NonthapatC/RapidAmentePDM/Controller/PDMController.step

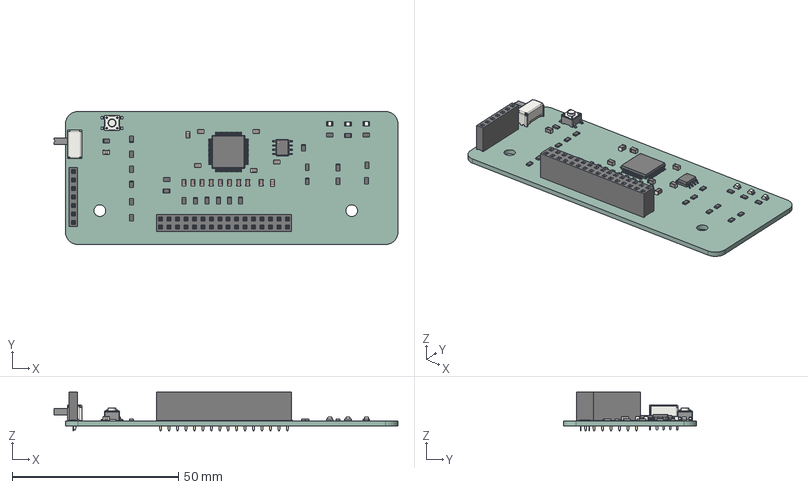
[picture p1: CAD file, 2026-08-03]
Controller/PDMController.step
103.4 x 40.0 x 11.6 mm
R_0805_2012Metric x 25
C_0805_2012Metric x 17
LED_0805_2012Metric x 3
LQFP-64_10x10mm_P0.5mm
SW_Slide_SPDT_Angled_CK_OS102011MA1Q
PinSocket_2x16_P2.54mm_Vertical
SW_SPST_PTS647Sx38
SOIC-8_3.9x4.9mm_P1.27mm
PinSocket_1x07_P2.54mm_Vertical
STM32 V2_PCB
