NonthapatC/RapidAmentePDM/KiCad_PDM/3Ds/XFCN T66145145-1500.step

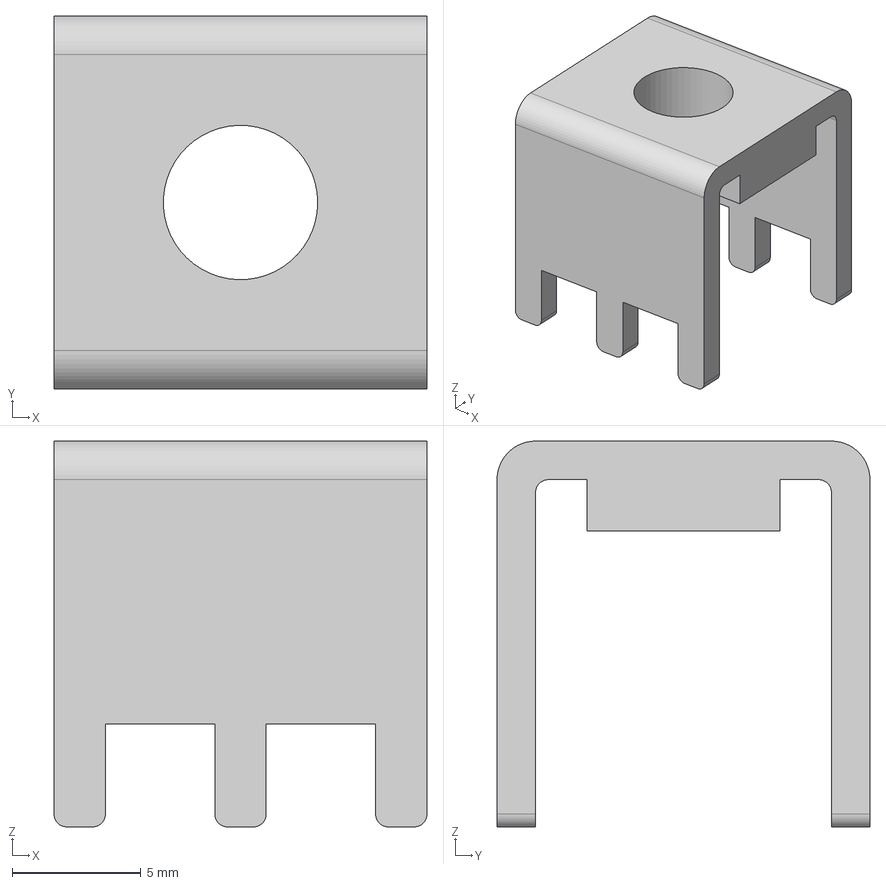
[picture p2: CAD file, 2026-04-13]
KiCad_PDM/3Ds/XFCN T66145145-1500.step
14.5 x 14.5 x 15.0 mm
