NonthapatC/RapidAmentePDM/Production/MK2_PDM.step

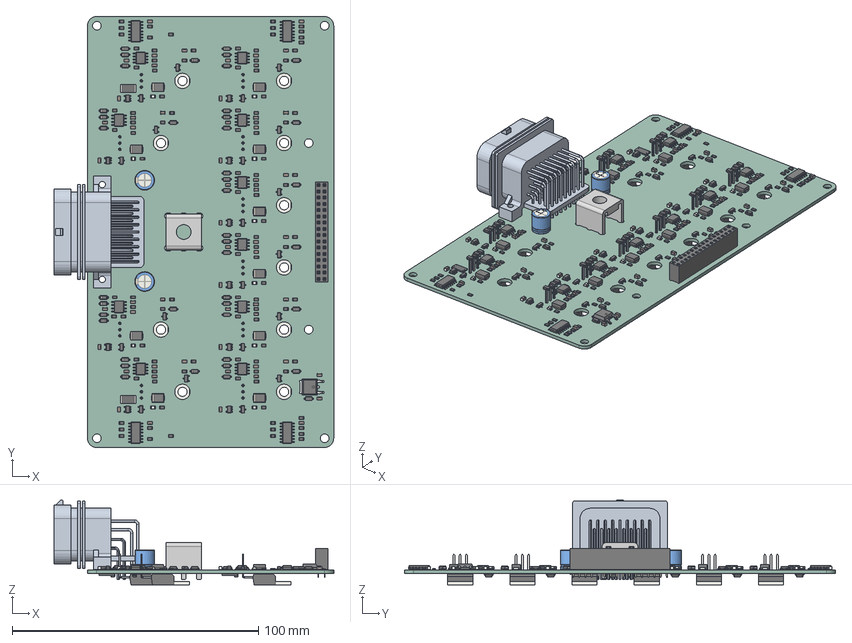
[picture p3: CAD file, 2026-07-30]
Production/MK2_PDM.step
113.5 x 175.0 x 34.3 mm
R_0805_2012Metric x 106
D_SMB x 10
C_0805_2012Metric x 56
D_SOD-123 x 51
SOT-23-5 x 10
SOT-23 x 20
SOIC-8_3.9x4.9mm_P1.27mm x 10
LED_0805_2012Metric x 10
Soldered Terminal XFCN T66145145-1500 v1
SOIC-14_3.9x8.7mm_P1.27mm x 4
R_2512_6332Metric x 10
CP_Radial_D80mm_P250mm x 2
C-6437288-1
932d09b3-9c39-11ed-93f0-dde97e994e83_part
932d09b4-9c39-11ed-93f0-dde97e994e83_part
932d09b5-9c39-11ed-93f0-dde97e994e83_part
PinSocket_2x16_P2.54mm_Vertical
TO-220-3_Horizontal_TabUp x 10
KiCad_PDM_PCB
