NonthapatC/RapidAmentePDM/Production/MK2_PDM_Design_Constraint.step

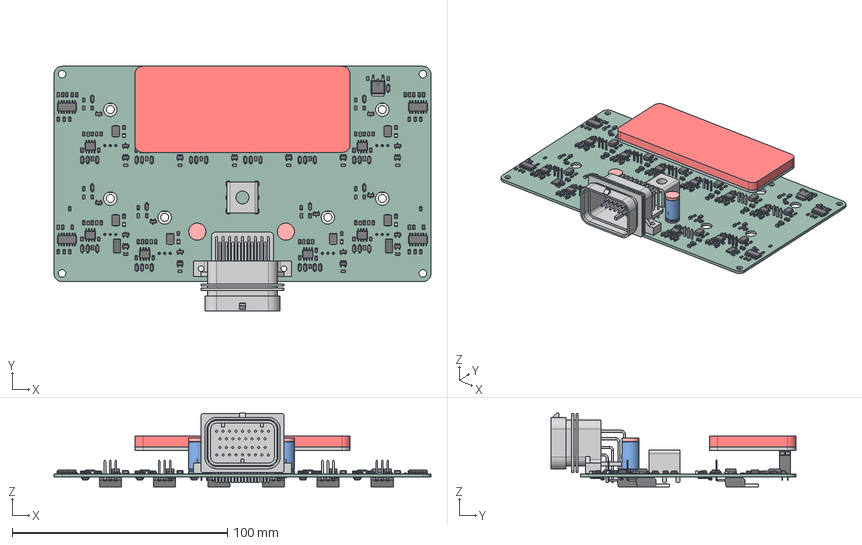
[picture p4: CAD file, 2026-07-30]
Production/MK2_PDM_Design_Constraint.step
175.0 x 113.5 x 34.3 mm
R_0805_2012Metric_1 x 106
D_SMB_1 x 10
C_0805_2012Metric_1 x 56
D_SOD-123_1 x 51
SOT-23-5_1 x 10
SOT-23_1 x 20
SOIC-8_3.9x4.9mm_P1.27mm_1 x 10
LED_0805_2012Metric_1 x 10
Soldered Terminal XFCN T66145145-1500 v1
SOIC-14_3.9x8.7mm_P1.27mm_1 x 4
R_2512_6332Metric_1 x 10
CP_Radial_D80mm_P250mm x 2
C-6437288-1
932d09b3-9c39-11ed-93f0-dde97e994e83_part
932d09b4-9c39-11ed-93f0-dde97e994e83_part
932d09b5-9c39-11ed-93f0-dde97e994e83_part
PinSocket_2x16_P2.54mm_Vertical_1
TO-220-3_Horizontal_TabUp_1 x 10
KiCad_PDM_PCB
100mill Male Pin Header_4P_Bk x 8
PDM_Board 2
PDM_Exclusion Volume
Bulk Caps Exclusion Volume x 2
