NonthapatC/RapidAmentePDM/KiCad_PDM/3Ds/6437288-1.stp

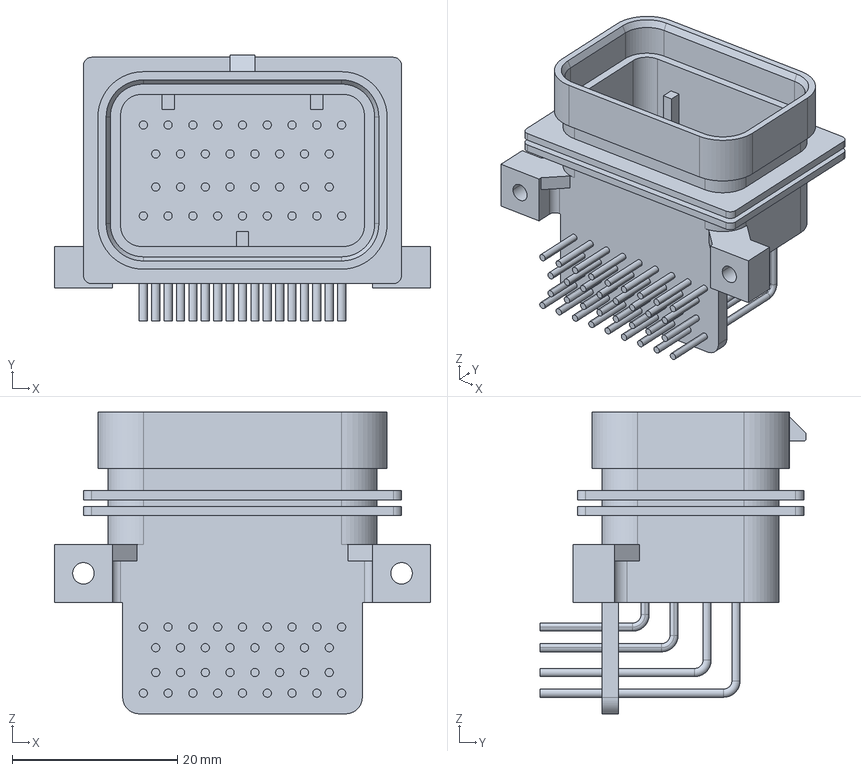
[picture p5: CAD file, 2026-04-03]
KiCad_PDM/3Ds/6437288-1.stp
45.5 x 32.1 x 36.5 mm
