NonthapatC/RapidAmentePDM/(list of files, cad)

Other CAD files:
Production/MK2_PDM_Design_Constraint.f3z
