NonthapatC/RapidAmentePDM/Controller/STM32 V2/STM32 V2.kicad_pcb

## KiCad design Controller/STM32 V2/STM32 V2.kicad_pcb (2026-08-03)

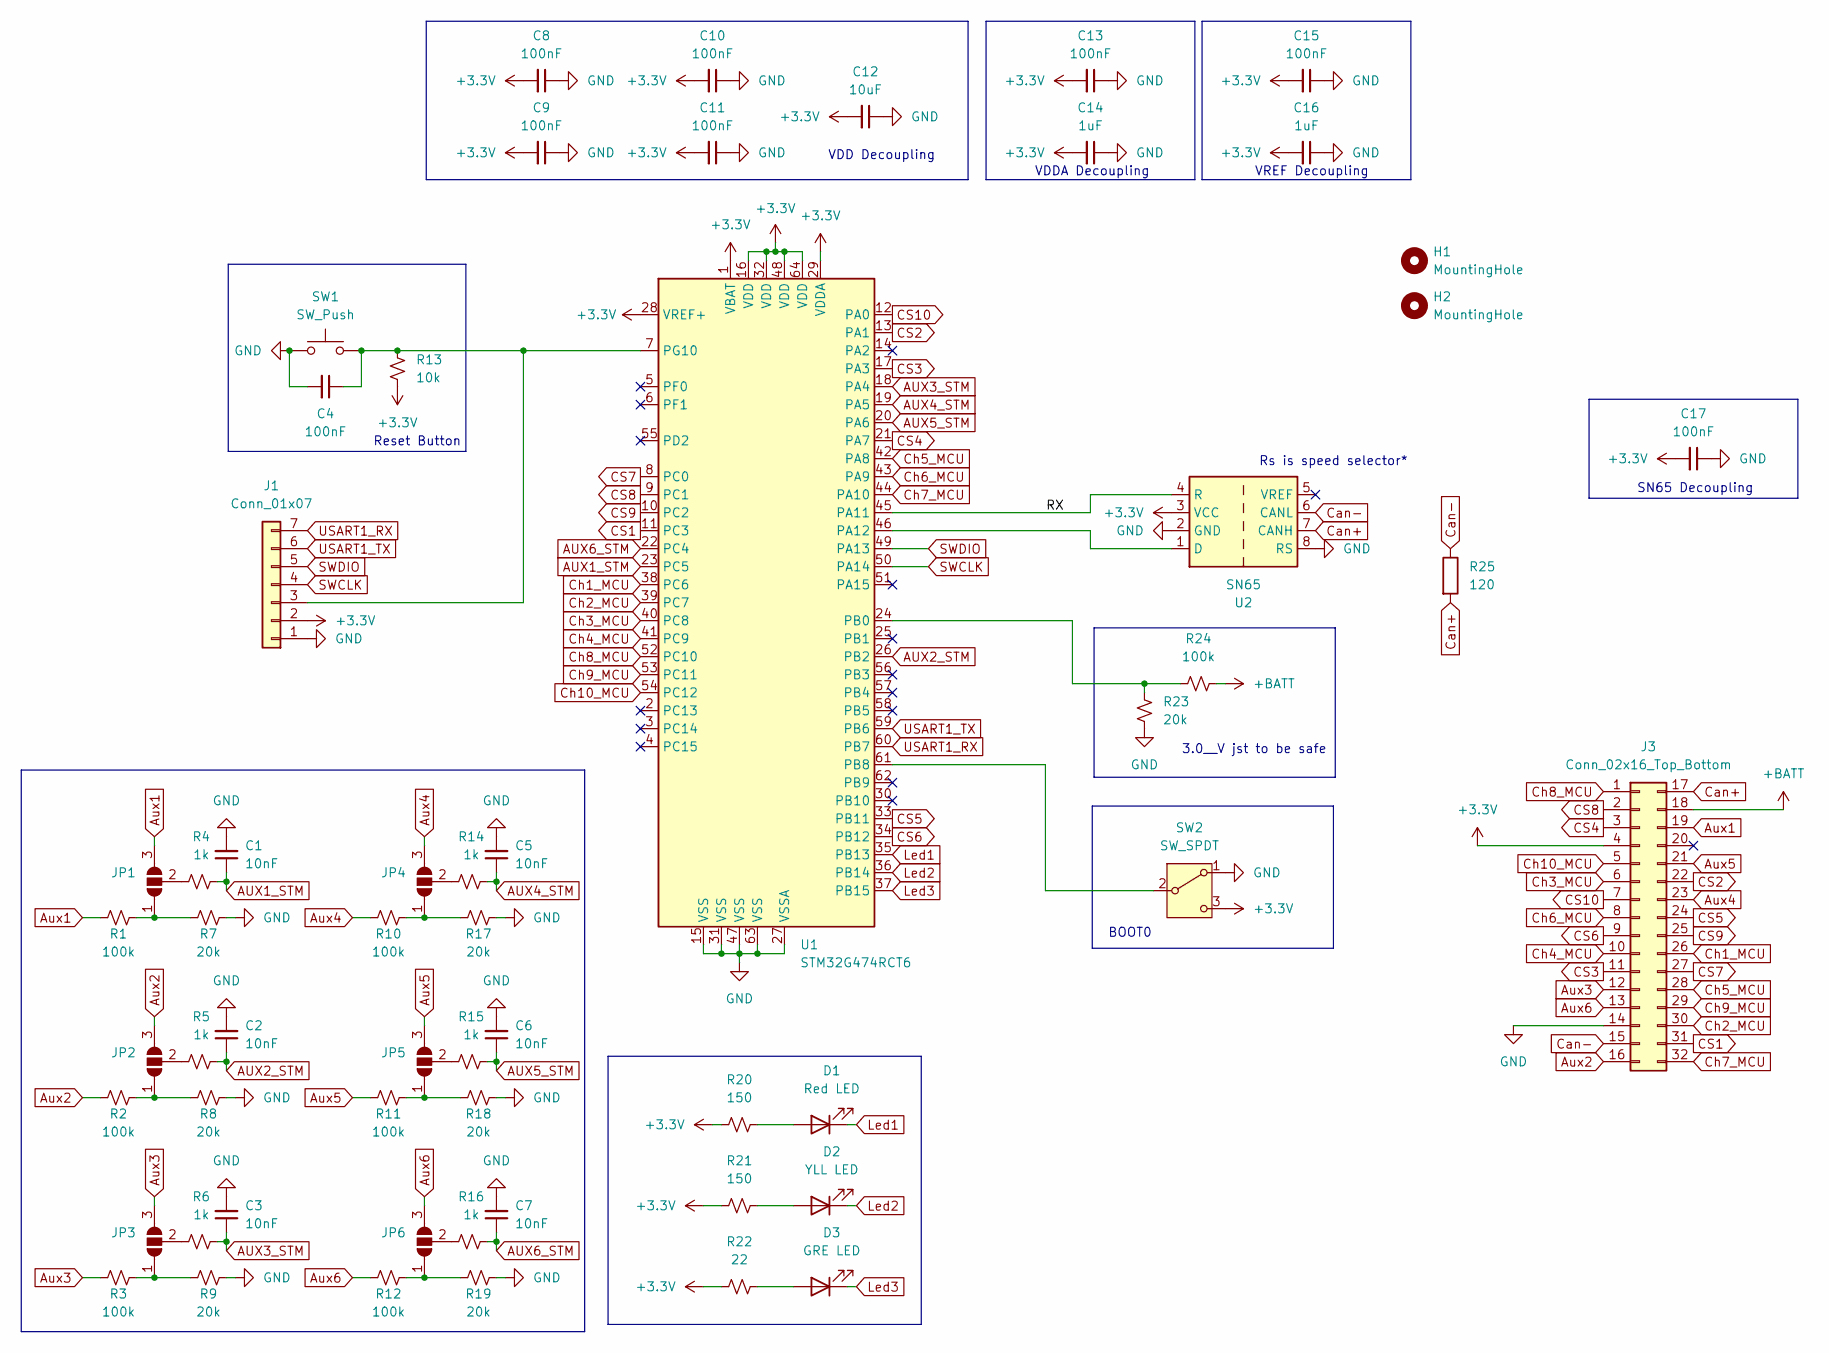
[picture p6: schematic STM32 V2.kicad_sch, STM 32 Board]

Parts:
C1, C2, C3, C5, C6, C7: 10nF; C_0805_2012Metric_Pad1.18x1.45mm_HandSolder
C4, C8, C9, C10, C11, C13, C15, C17: 100nF; C_0805_2012Metric_Pad1.18x1.45mm_HandSolder
C12: 10uF; C_0805_2012Metric_Pad1.18x1.45mm_HandSolder
C14, C16: 1uF; C_0805_2012Metric_Pad1.18x1.45mm_HandSolder
D1: Red LED; LED_0805_2012Metric_Pad1.15x1.40mm_HandSolder
D2: YLL LED; LED_0805_2012Metric_Pad1.15x1.40mm_HandSolder
D3: GRE LED; LED_0805_2012Metric_Pad1.15x1.40mm_HandSolder
H1, H2: MountingHole; MountingHole_NPTH_3.5_6.25SB
J1: Conn_01x07; PinSocket_1x07_P2.54mm_Vertical
J3: Conn_02x16_Top_Bottom; PinSocket_2x16_P2.54mm_Vertical
JP1, JP2, JP3, JP4, JP5, JP6: SolderJumper_3_Open; SolderJumper-3_P1.3mm_Open_RoundedPad1.0x1.5mm_NumberLabels
R1, R2, R3, R10, R11, R12, R24: 100k; R_0805_2012Metric_Pad1.20x1.40mm_HandSolder
R4, R5, R6, R14, R15, R16: 1k; R_0805_2012Metric_Pad1.20x1.40mm_HandSolder
R7, R8, R9, R17, R18, R19, R23: 20k; R_0805_2012Metric_Pad1.20x1.40mm_HandSolder
R13: 10k; R_0805_2012Metric_Pad1.20x1.40mm_HandSolder
R20, R21: 150; R_0805_2012Metric_Pad1.20x1.40mm_HandSolder
R22: 22; R_0805_2012Metric_Pad1.20x1.40mm_HandSolder
R25: 120; R_0805_2012Metric_Pad1.20x1.40mm_HandSolder
SW1: SW_Push; SW_SPST_PTS647_Sx38
SW2: SW_SPDT; HOOYA MK-12D13G4-B
U1: STM32G474RCT6; LQFP-64_10x10mm_P0.5mm
U2: SN65; SOIC-8_3.9x4.9mm_P1.27mm

Connections:
+3.3V: C8.2, C9.2, C10.2, C11.2, C12.2, C13.2, C14.2, C15.2, C16.2, C17.2, J1.2, J3.4, R13.2, R20.2, R21.2, R22.2, SW2.3 (C), U1.1 (VBAT), U1.16 (VDD), U1.28 (VREF+), U1.29 (VDDA), U1.32 (VDD), U1.48 (VDD), U1.64 (VDD), U2.3 (VCC)
+BATT: J3.18, R24.2
/RX: U1.45 (PA11), U2.4 (R)
AUX1_STM: C1.1, R4.2, U1.23 (PC5)
AUX2_STM: C2.1, R5.2, U1.26 (PB2)
AUX3_STM: C3.1, R6.2, U1.18 (PA4)
AUX4_STM: C5.1, R14.2, U1.19 (PA5)
AUX5_STM: C6.1, R15.2, U1.20 (PA6)
AUX6_STM: C7.1, R16.2, U1.22 (PC4)
Aux1: J3.19, JP1.3 (B), R1.1
Aux2: J3.16, JP2.3 (B), R2.1
Aux3: J3.12, JP3.3 (B), R3.1
Aux4: J3.23, JP4.3 (B), R10.1
Aux5: J3.21, JP5.3 (B), R11.1
Aux6: J3.13, JP6.3 (B), R12.1
CS1: J3.31, U1.11 (PC3)
CS2: J3.22, U1.13 (PA1)
CS3: J3.11, U1.17 (PA3)
CS4: J3.3, U1.21 (PA7)
CS5: J3.24, U1.33 (PB11)
CS6: J3.9, U1.34 (PB12)
CS7: J3.27, U1.8 (PC0)
CS8: J3.2, U1.9 (PC1)
CS9: J3.25, U1.10 (PC2)
CS10: J3.7, U1.12 (PA0)
Can+: J3.17, R25.2, U2.7 (CANH)
Can-: J3.15, R25.1, U2.6 (CANL)
Ch1_MCU: J3.26, U1.38 (PC6)
Ch2_MCU: J3.30, U1.39 (PC7)
Ch3_MCU: J3.6, U1.40 (PC8)
Ch4_MCU: J3.10, U1.41 (PC9)
Ch5_MCU: J3.28, U1.42 (PA8)
Ch6_MCU: J3.8, U1.43 (PA9)
Ch7_MCU: J3.32, U1.44 (PA10)
Ch8_MCU: J3.1, U1.52 (PC10)
Ch9_MCU: J3.29, U1.53 (PC11)
Ch10_MCU: J3.5, U1.54 (PC12)
GND: C1.2, C2.2, C3.2, C4.2, C5.2, C6.2, C7.2, C8.1, C9.1, C10.1, C11.1, C12.1, C13.1, C14.1, C15.1, C16.1, C17.1, J1.1, J3.14, R7.2, R8.2, R9.2, R17.2, R18.2, R19.2, R23.1, SW1.1, SW2.1 (A), U1.15 (VSS), U1.27 (VSSA), U1.31 (VSS), U1.47 (VSS), U1.63 (VSS), U2.2 (GND), U2.8 (RS)
Led1: D1.1 (K), U1.35 (PB13)
Led2: D2.1 (K), U1.36 (PB14)
Led3: D3.1 (K), U1.37 (PB15)
unnamed: D1.2 (A), R20.1
unnamed: D2.2 (A), R21.1
unnamed: D3.2 (A), R22.1
unnamed: C4.1, J1.3, R13.1, SW1.2, U1.7 (PG10)
unnamed: JP1.1 (A), R1.2, R7.1
unnamed: JP1.2 (C), R4.1
unnamed: JP2.1 (A), R2.2, R8.1
unnamed: JP2.2 (C), R5.1
unnamed: JP3.1 (A), R3.2, R9.1
unnamed: JP3.2 (C), R6.1
unnamed: JP4.1 (A), R10.2, R17.1
unnamed: JP4.2 (C), R14.1
unnamed: JP5.1 (A), R11.2, R18.1
unnamed: JP5.2 (C), R15.1
unnamed: JP6.1 (A), R12.2, R19.1
unnamed: JP6.2 (C), R16.1
unnamed: SW2.2 (B), U1.61 (PB8)
unnamed: U1.46 (PA12), U2.1 (D)
unnamed: R23.2, R24.1, U1.24 (PB0)
SWCLK: J1.4, U1.50 (PA14)
SWDIO: J1.5, U1.49 (PA13)
USART1_RX: J1.7, U1.60 (PB7)
USART1_TX: J1.6, U1.59 (PB6)

Notes on the sheet:
BOOT0
SN65 Decoupling
VDD Decoupling
Reset Button
VREF Decoupling
VDDA Decoupling
3.0__V jst to be safe
Rs is speed selector*

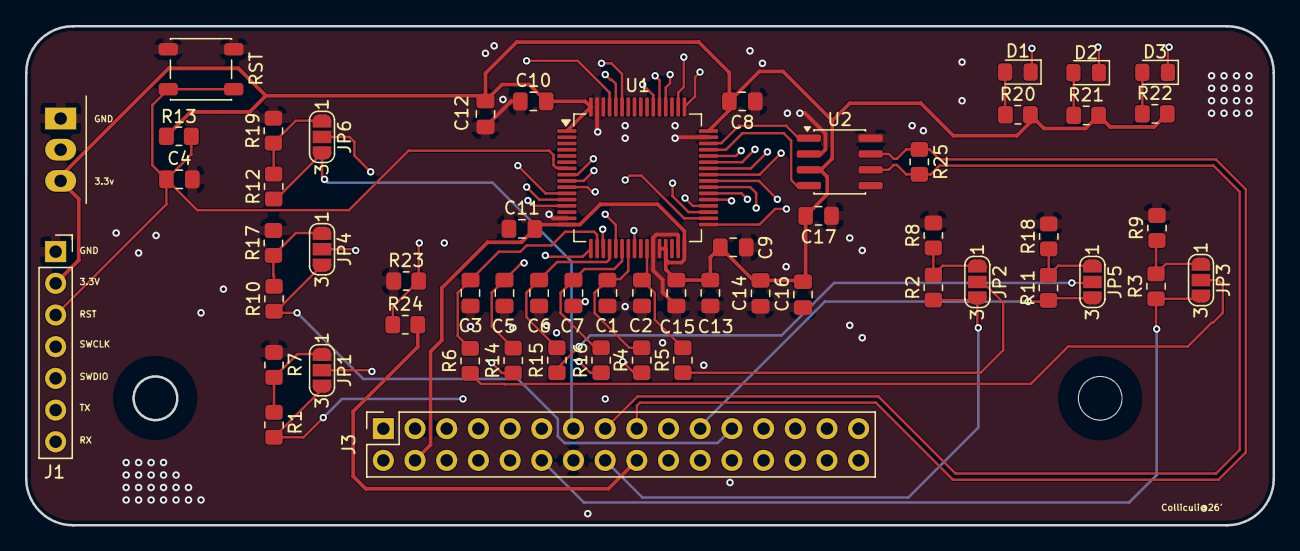
[picture p7: board STM32 V2.kicad_pcb from above]

Board: 4 copper layers, 100.0 x 40.0 mm, 59 parts (0 on the bottom side), 64 nets.
