NonthapatC/RapidAmentePDM/KiCad_PDM/KiCad_PDM.kicad_pcb

## KiCad design KiCad_PDM/KiCad_PDM.kicad_pcb (2026-08-02)

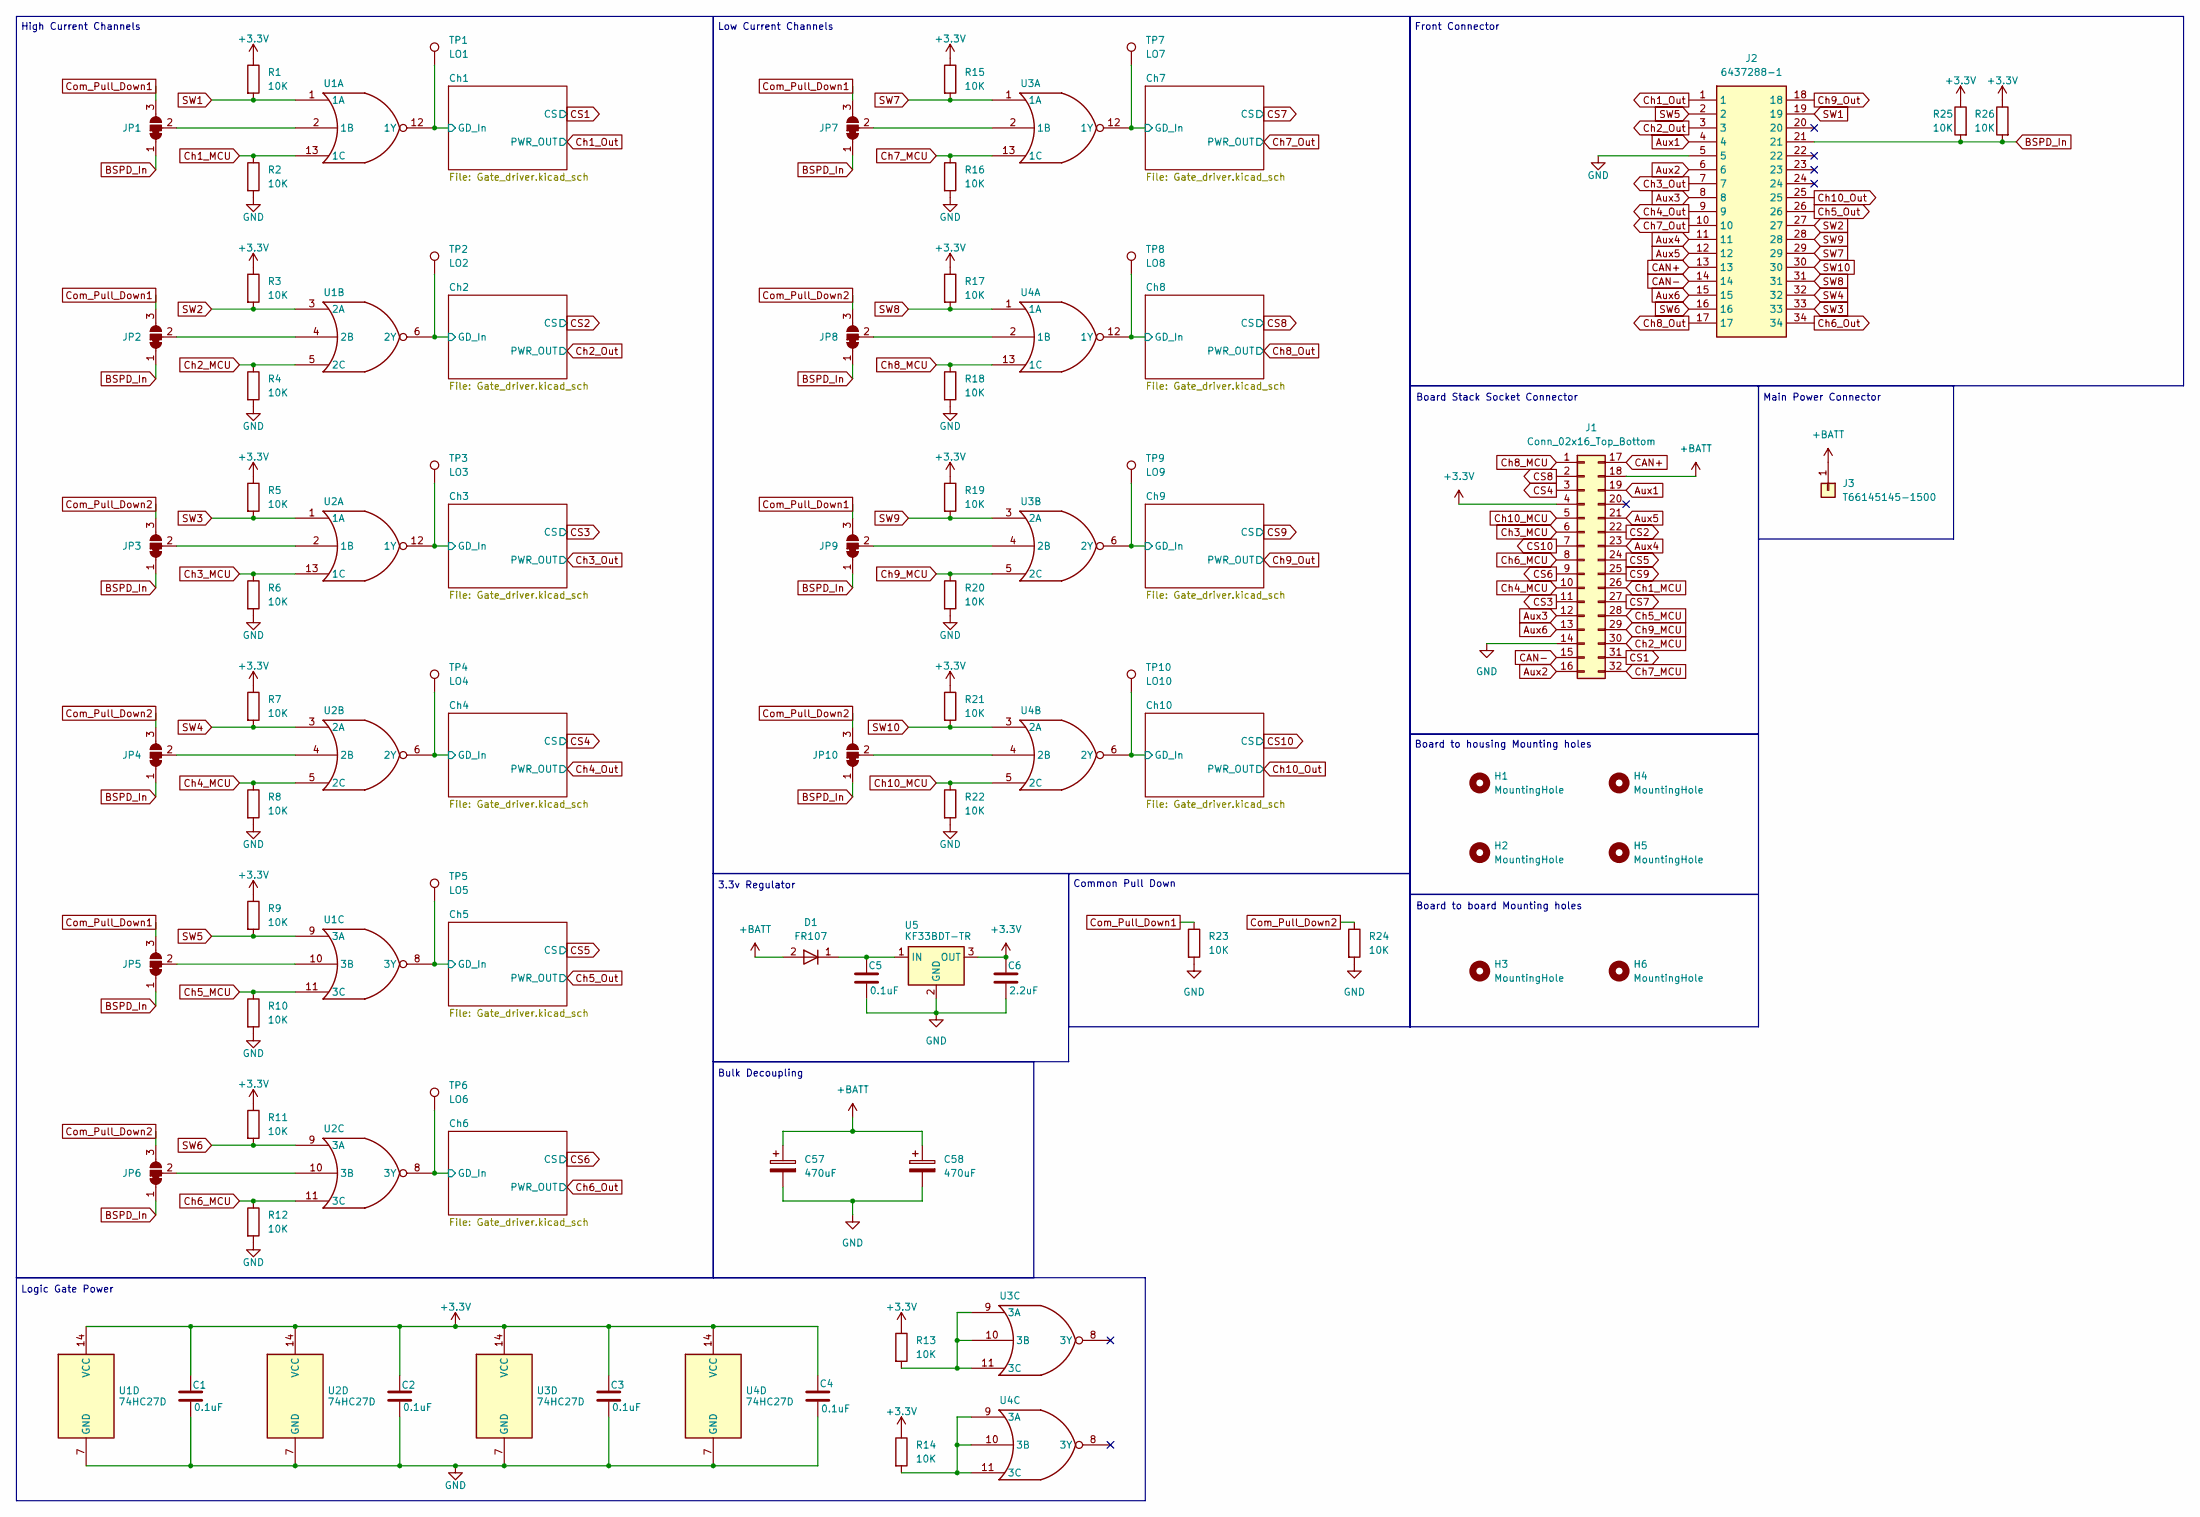
[picture p8: schematic KiCad_PDM.kicad_sch]

Parts:
C1, C2, C3, C4, C5: 0.1uF; C_0805_2012Metric_Pad1.18x1.45mm_HandSolder
C6: 2.2uF; C_0805_2012Metric_Pad1.18x1.45mm_HandSolder
C57, C58: 470uF; CP_Radial_D8.0mm_P2.50mm
D1: FR107; D_SOD-123
H1, H2, H3, H4, H5, H6: MountingHole; MountingHole_NPTH_3.5_6.25SB
J1: Conn_02x16_Top_Bottom; PinSocket_2x16_P2.54mm_Vertical
J2: 6437288-1; Mouser Part Number 571-6437288-1
J3: T66145145-1500; XFCN T66145145-1500
JP1, JP2, JP3, JP4, JP5, JP6, JP7, JP8, JP9, JP10: SolderJumper_3_Bridged12; SolderJumper-3_P1.3mm_Bridged2Bar12_RoundedPad1.0x1.5mm_Num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
R1, R2, R3, R4, R5, R6, R7, R8, R9, R10, R11, R12, R13, R14, R15, R16, R17, R18, R19, R20, R21, R22, R23, R24, R25, R26: 10K; R_0805_2012Metric_Pad1.20x1.40mm_HandSolder
TP1: LO1; Custom_Testpad
TP2: LO2; Custom_Testpad
TP3: LO3; Custom_Testpad
TP4: LO4; Custom_Testpad
TP5: LO5; Custom_Testpad
TP6: LO6; Custom_Testpad
TP7: LO7; Custom_Testpad
TP8: LO8; Custom_Testpad
TP9: LO9; Custom_Testpad
TP10: LO10; Custom_Testpad
U1, U2, U3, U4: 74HC27D; SOIC-14_3.9x8.7mm_P1.27mm
U5: KF33BDT-TR; TO-252-2

Connections:
+3.3V: C1.1, C2.1, C3.1, C4.1, C6.1, J1.4, R1.1, R3.1, R5.1, R7.1, R9.1, R11.1, R13.1, R14.1, R15.1, R17.1, R19.1, R21.1, R25.1, R26.1, U1.14 (VCC), U2.14 (VCC), U3.14 (VCC), U4.14 (VCC), U5.3 (OUT); also elsewhere on the board
+BATT: C57.1, C58.1, D1.2, J1.18, J3.1 (Pin_1_1); also elsewhere on the board
/Ch1/GD_In: TP1.1 (1_1), U1.12 (1Y); also elsewhere on the board
/Ch2/GD_In: TP2.1 (1_1), U1.6 (2Y); also elsewhere on the board
/Ch3/GD_In: TP3.1 (1_1), U2.12 (1Y); also elsewhere on the board
/Ch4/GD_In: TP4.1 (1_1), U2.6 (2Y); also elsewhere on the board
/Ch5/GD_In: TP5.1 (1_1), U1.8 (3Y); also elsewhere on the board
/Ch6/GD_In: TP6.1 (1_1), U2.8 (3Y); also elsewhere on the board
/Ch7/GD_In: TP7.1 (1_1), U3.12 (1Y); also elsewhere on the board
/Ch8/GD_In: TP8.1 (1_1), U4.12 (1Y); also elsewhere on the board
/Ch9/GD_In: TP9.1 (1_1), U3.6 (2Y); also elsewhere on the board
/Ch10/GD_In: TP10.1 (1_1), U4.6 (2Y); also elsewhere on the board
Aux1: J1.19, J2.4
Aux2: J1.16, J2.6
Aux3: J1.12, J2.8
Aux4: J1.23, J2.11
Aux5: J1.21, J2.12
Aux6: J1.13, J2.15
BSPD_In: J2.21, JP1.1 (A), JP2.1 (A), JP3.1 (A), JP4.1 (A), JP5.1 (A), JP6.1 (A), JP7.1 (A), JP8.1 (A), JP9.1 (A), JP10.1 (A), R25.2, R26.2
CAN+: J1.17, J2.13
CAN-: J1.15, J2.14
CS1: J1.31; also elsewhere on the board
CS2: J1.22; also elsewhere on the board
CS3: J1.11; also elsewhere on the board
CS4: J1.3; also elsewhere on the board
CS5: J1.24; also elsewhere on the board
CS6: J1.9; also elsewhere on the board
CS7: J1.27; also elsewhere on the board
CS8: J1.2; also elsewhere on the board
CS9: J1.25; also elsewhere on the board
CS10: J1.7; also elsewhere on the board
Ch1_MCU: J1.26, R2.1, U1.13 (1C)
Ch1_Out: J2.1; also elsewhere on the board
Ch2_MCU: J1.30, R4.1, U1.5 (2C)
Ch2_Out: J2.3; also elsewhere on the board
Ch3_MCU: J1.6, R6.1, U2.13 (1C)
Ch3_Out: J2.7; also elsewhere on the board
Ch4_MCU: J1.10, R8.1, U2.5 (2C)
Ch4_Out: J2.9; also elsewhere on the board
Ch5_MCU: J1.28, R10.1, U1.11 (3C)
Ch5_Out: J2.26; also elsewhere on the board
Ch6_MCU: J1.8, R12.1, U2.11 (3C)
Ch6_Out: J2.34; also elsewhere on the board
Ch7_MCU: J1.32, R16.1, U3.13 (1C)
Ch7_Out: J2.10; also elsewhere on the board
Ch8_MCU: J1.1, R18.1, U4.13 (1C)
Ch8_Out: J2.17; also elsewhere on the board
Ch9_MCU: J1.29, R20.1, U3.5 (2C)
Ch9_Out: J2.18; also elsewhere on the board
Ch10_MCU: J1.5, R22.1, U4.5 (2C)
Ch10_Out: J2.25; also elsewhere on the board
Com_Pull_Down1: JP1.3 (B), JP2.3 (B), JP5.3 (B), JP7.3 (B), JP9.3 (B), R23.1
Com_Pull_Down2: JP3.3 (B), JP4.3 (B), JP6.3 (B), JP8.3 (B), JP10.3 (B), R24.1
GND: C1.2, C2.2, C3.2, C4.2, C5.2, C6.2, C57.2, C58.2, J1.14, J2.5, R2.2, R4.2, R6.2, R8.2, R10.2, R12.2, R16.2, R18.2, R20.2, R22.2, R23.2, R24.2, U1.7 (GND), U2.7 (GND), U3.7 (GND), U4.7 (GND), U5.2 (GND); also elsewhere on the board
unnamed: JP1.2 (C), U1.2 (1B)
unnamed: JP2.2 (C), U1.4 (2B)
unnamed: JP3.2 (C), U2.2 (1B)
unnamed: JP4.2 (C), U2.4 (2B)
unnamed: JP5.2 (C), U1.10 (3B)
unnamed: JP6.2 (C), U2.10 (3B)
unnamed: JP7.2 (C), U3.2 (1B)
unnamed: JP8.2 (C), U4.2 (1B)
unnamed: JP9.2 (C), U3.4 (2B)
unnamed: JP10.2 (C), U4.4 (2B)
unnamed: R13.2, U3.9 (3A), U3.10 (3B), U3.11 (3C)
unnamed: R14.2, U4.9 (3A), U4.10 (3B), U4.11 (3C)
unnamed: C5.1, D1.1, U5.1 (IN)
SW1: J2.19, R1.2, U1.1 (1A)
SW2: J2.27, R3.2, U1.3 (2A)
SW3: J2.33, R5.2, U2.1 (1A)
SW4: J2.32, R7.2, U2.3 (2A)
SW5: J2.2, R9.2, U1.9 (3A)
SW6: J2.16, R11.2, U2.9 (3A)
SW7: J2.29, R15.2, U3.1 (1A)
SW8: J2.31, R17.2, U4.1 (1A)
SW9: J2.28, R19.2, U3.3 (2A)
SW10: J2.30, R21.2, U4.3 (2A)

Notes on the sheet:
Bulk Decoupling
3.3v Regulator
Board Stack Socket Connector
Common Pull Down
Low Current Channels
Logic Gate Power
Front Connector
High Current Channels
Main Power Connector
Board to housing Mounting holes
Board to board Mounting holes

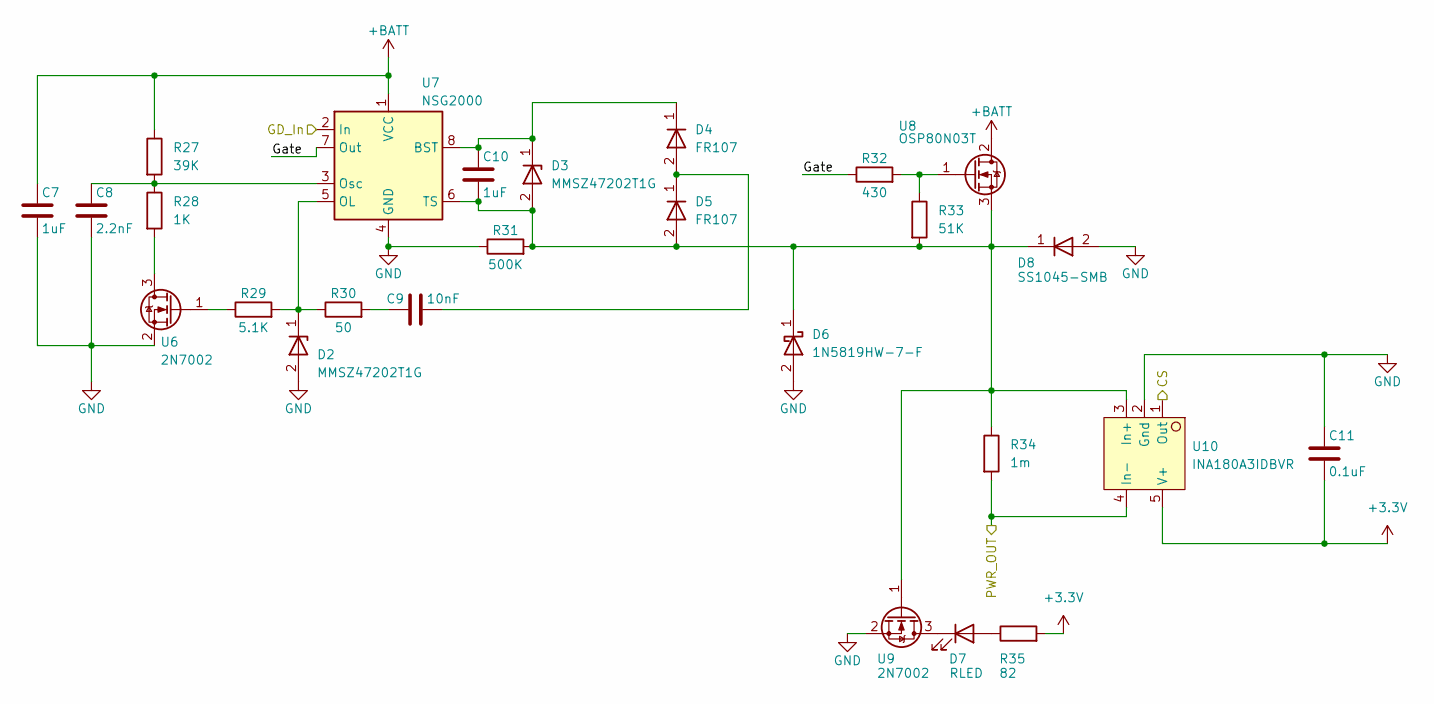
[picture p9: schematic Gate_driver.kicad_sch]

Parts:
C7, C10: 1uF; C_0805_2012Metric_Pad1.18x1.45mm_HandSolder
C8: 2.2nF; C_0805_2012Metric_Pad1.18x1.45mm_HandSolder
C9: 10nF; C_0805_2012Metric_Pad1.18x1.45mm_HandSolder
C11: 0.1uF; C_0805_2012Metric_Pad1.18x1.45mm_HandSolder
D2, D3: MMSZ47202T1G; D_SOD-123
D4, D5: FR107; D_SOD-123
D6: 1N5819HW-7-F; D_SOD-123
D7: RLED; LED_0805_2012Metric_Pad1.15x1.40mm_HandSolder
D8: SS1045-SMB; D_SMB_Handsoldering
R27: 39K; R_0805_2012Metric_Pad1.20x1.40mm_HandSolder
R28: 1K; R_0805_2012Metric_Pad1.20x1.40mm_HandSolder
R29: 5.1K; R_0805_2012Metric_Pad1.20x1.40mm_HandSolder
R30: 50; R_0805_2012Metric_Pad1.20x1.40mm_HandSolder
R31: 500K; R_0805_2012Metric_Pad1.20x1.40mm_HandSolder
R32: 430; R_0805_2012Metric_Pad1.20x1.40mm_HandSolder
R33: 51K; R_0805_2012Metric_Pad1.20x1.40mm_HandSolder
R34: 1m; R_2512_6332Metric_Pad1.40x3.35mm_HandSolder
R35: 82; R_0805_2012Metric_Pad1.20x1.40mm_HandSolder
U6, U9: 2N7002; SOT-23_Handsoldering
U7: NSG2000; SOIC-8_3.9x4.9mm_P1.27mm
U8: OSP80N03T; Bolt_head_clearance_TO-220-3_Horizontal_TabUp
U10: INA180A3IDBVR; SOT-23-5_HandSoldering

Connections:
+3.3V: C11.2, R35.2, U10.5 (V+); also elsewhere on the board
+BATT: C7.1, R27.1, U7.1 (VCC), U8.2 (Drain); also elsewhere on the board
/Ch1/GD_In: U7.2 (In); also elsewhere on the board
/Ch1/Gate: R32.1, U7.7 (Out)
CS1: U10.1 (Out); also elsewhere on the board
Ch1_Out: R34.2, U10.4 (In-); also elsewhere on the board
GND: C7.2, C8.2, C11.1, D2.2, D6.2 (A), D8.2, R31.1, U6.2 (S), U7.4 (GND), U9.2 (S), U10.2 (Gnd); also elsewhere on the board
unnamed: C9.1, R30.2
unnamed: C9.2, D4.2, D5.1
unnamed: C10.2, D3.2, D5.2, D6.1 (K), D8.1, R31.2, R33.2, R34.1, U7.6 (TS), U8.3 (Source), U9.1 (G), U10.3 (In+)
unnamed: D7.2 (A), R35.1
unnamed: D7.1 (K), U9.3 (D)
unnamed: R28.2, U6.3 (D)
unnamed: R29.1, U6.1 (G)
unnamed: C10.1, D3.1, D4.1, U7.8 (BST)
unnamed: D2.1, R29.2, R30.1, U7.5 (OL)
unnamed: C8.1, R27.2, R28.1, U7.3 (Osc)
unnamed: R32.2, R33.1, U8.1 (Gate)

Parts of its further copies:
C12, C15, C17, C20, C22, C25, C27, C30, C32, C35, C37, C40, C42, C45, C47, C50, C52, C55: 1uF; C_0805_2012Metric_Pad1.18x1.45mm_HandSolder
C13, C18, C23, C28, C33, C38, C43, C48, C53: 2.2nF; C_0805_2012Metric_Pad1.18x1.45mm_HandSolder
C14, C19, C24, C29, C34, C39, C44, C49, C54: 10nF; C_0805_2012Metric_Pad1.18x1.45mm_HandSolder
C16, C21, C26, C31, C36, C41, C46, C51, C56: 0.1uF; C_0805_2012Metric_Pad1.18x1.45mm_HandSolder
D9, D10, D16, D17, D23, D24, D30, D31, D37, D38, D44, D45, D51, D52, D58, D59, D65, D66: MMSZ47202T1G; D_SOD-123
D11, D12, D18, D19, D25, D26, D32, D33, D39, D40, D46, D47, D53, D54, D60, D61, D67, D68: FR107; D_SOD-123
D13, D20, D27, D34, D41, D48, D55, D62, D69: 1N5819HW-7-F; D_SOD-123
D14, D21, D28, D35, D42, D49, D56, D63, D70: RLED; LED_0805_2012Metric_Pad1.15x1.40mm_HandSolder
D15, D22, D29, D36, D43, D50, D57, D64, D71: SS1045-SMB; D_SMB_Handsoldering
R36, R45, R54, R63, R72, R81, R90, R99, R108: 39K; R_0805_2012Metric_Pad1.20x1.40mm_HandSolder
R37, R46, R55, R64, R73, R82, R91, R100, R109: 1K; R_0805_2012Metric_Pad1.20x1.40mm_HandSolder
R38, R47, R56, R65, R74, R83, R92, R101, R110: 5.1K; R_0805_2012Metric_Pad1.20x1.40mm_HandSolder
R39, R48, R57, R66, R75, R84, R93, R102, R111: 50; R_0805_2012Metric_Pad1.20x1.40mm_HandSolder
R40, R49, R58, R67, R76, R85, R94, R103, R112: 500K; R_0805_2012Metric_Pad1.20x1.40mm_HandSolder
R41, R50, R59, R68, R77, R86, R95, R104, R113: 430; R_0805_2012Metric_Pad1.20x1.40mm_HandSolder
R42, R51, R60, R69, R78, R87, R96, R105, R114: 51K; R_0805_2012Metric_Pad1.20x1.40mm_HandSolder
R43, R52, R61, R70, R79, R88, R97, R106, R115: 1m; R_2512_6332Metric_Pad1.40x3.35mm_HandSolder
R44, R53, R62, R71, R80, R89, R98, R107, R116: 82; R_0805_2012Metric_Pad1.20x1.40mm_HandSolder
U11, U14, U16, U19, U21, U24, U26, U29, U31, U34, U36, U39, U41, U44, U46, U49, U51, U54: 2N7002; SOT-23_Handsoldering
U12, U17, U22, U27, U32, U37, U42, U47, U52: NSG2000; SOIC-8_3.9x4.9mm_P1.27mm
U13, U18, U23, U28, U33, U38, U43, U48, U53: OSP80N03T; Bolt_head_clearance_TO-220-3_Horizontal_TabUp
U15, U20, U25, U30, U35, U40, U45, U50, U55: INA180A3IDBVR; SOT-23-5_HandSoldering

Connections of its further copies:
+3.3V: C16.2, C21.2, C26.2, C31.2, C36.2, C41.2, C46.2, C51.2, C56.2, R44.2, R53.2, R62.2, R71.2, R80.2, R89.2, R98.2, R107.2, R116.2, U15.5 (V+), U20.5 (V+), U25.5 (V+), U30.5 (V+), U35.5 (V+), U40.5 (V+), U45.5 (V+), U50.5 (V+), U55.5 (V+); also elsewhere on the board
+BATT: C12.1, C17.1, C22.1, C27.1, C32.1, C37.1, C42.1, C47.1, C52.1, R36.1, R45.1, R54.1, R63.1, R72.1, R81.1, R90.1, R99.1, R108.1, U12.1 (VCC), U13.2 (Drain), U17.1 (VCC), U18.2 (Drain), U22.1 (VCC), U23.2 (Drain), U27.1 (VCC), U28.2 (Drain), U32.1 (VCC), U33.2 (Drain), U37.1 (VCC), U38.2 (Drain), U42.1 (VCC), U43.2 (Drain), U47.1 (VCC), U48.2 (Drain), U52.1 (VCC), U53.2 (Drain); also elsewhere on the board
/Ch2/GD_In: U12.2 (In); also elsewhere on the board
/Ch2/Gate: R41.1, U12.7 (Out)
/Ch3/GD_In: U17.2 (In); also elsewhere on the board
/Ch3/Gate: R50.1, U17.7 (Out)
/Ch4/GD_In: U22.2 (In); also elsewhere on the board
/Ch4/Gate: R59.1, U22.7 (Out)
/Ch5/GD_In: U27.2 (In); also elsewhere on the board
/Ch5/Gate: R68.1, U27.7 (Out)
/Ch6/GD_In: U32.2 (In); also elsewhere on the board
/Ch6/Gate: R77.1, U32.7 (Out)
/Ch7/GD_In: U37.2 (In); also elsewhere on the board
/Ch7/Gate: R86.1, U37.7 (Out)
/Ch8/GD_In: U42.2 (In); also elsewhere on the board
/Ch8/Gate: R95.1, U42.7 (Out)
/Ch9/GD_In: U47.2 (In); also elsewhere on the board
/Ch9/Gate: R104.1, U47.7 (Out)
/Ch10/GD_In: U52.2 (In); also elsewhere on the board
/Ch10/Gate: R113.1, U52.7 (Out)
CS2: U15.1 (Out); also elsewhere on the board
CS3: U20.1 (Out); also elsewhere on the board
CS4: U25.1 (Out); also elsewhere on the board
CS5: U30.1 (Out); also elsewhere on the board
CS6: U35.1 (Out); also elsewhere on the board
CS7: U40.1 (Out); also elsewhere on the board
CS8: U45.1 (Out); also elsewhere on the board
CS9: U50.1 (Out); also elsewhere on the board
CS10: U55.1 (Out); also elsewhere on the board
Ch2_Out: R43.2, U15.4 (In-); also elsewhere on the board
Ch3_Out: R52.2, U20.4 (In-); also elsewhere on the board
Ch4_Out: R61.2, U25.4 (In-); also elsewhere on the board
Ch5_Out: R70.2, U30.4 (In-); also elsewhere on the board
Ch6_Out: R79.2, U35.4 (In-); also elsewhere on the board
Ch7_Out: R88.2, U40.4 (In-); also elsewhere on the board
Ch8_Out: R97.2, U45.4 (In-); also elsewhere on the board
Ch9_Out: R106.2, U50.4 (In-); also elsewhere on the board
Ch10_Out: R115.2, U55.4 (In-); also elsewhere on the board
GND: C12.2, C13.2, C16.1, C17.2, C18.2, C21.1, C22.2, C23.2, C26.1, C27.2, C28.2, C31.1, C32.2, C33.2, C36.1, C37.2, C38.2, C41.1, C42.2, C43.2, C46.1, C47.2, C48.2, C51.1, C52.2, C53.2, C56.1, D9.2, D13.2 (A), D15.2, D16.2, D20.2 (A), D22.2, D23.2, D27.2 (A), D29.2, D30.2, D34.2 (A), D36.2, D37.2, D41.2 (A), D43.2, D44.2, D48.2 (A), D50.2, D51.2, D55.2 (A), D57.2, D58.2, D62.2 (A), D64.2, D65.2, D69.2 (A), D71.2, R40.1, R49.1, R58.1, R67.1, R76.1, R85.1, R94.1, R103.1, R112.1, U11.2 (S), U12.4 (GND), U14.2 (S), U15.2 (Gnd), U16.2 (S), U17.4 (GND), U19.2 (S), U20.2 (Gnd), U21.2 (S), U22.4 (GND), U24.2 (S), U25.2 (Gnd), U26.2 (S), U27.4 (GND), U29.2 (S), U30.2 (Gnd), U31.2 (S), U32.4 (GND), U34.2 (S), U35.2 (Gnd), U36.2 (S), U37.4 (GND), U39.2 (S), U40.2 (Gnd), U41.2 (S), U42.4 (GND), U44.2 (S), U45.2 (Gnd), U46.2 (S), U47.4 (GND), U49.2 (S), U50.2 (Gnd), U51.2 (S), U52.4 (GND), U54.2 (S), U55.2 (Gnd); also elsewhere on the board
unnamed: C14.1, R39.2
unnamed: C14.2, D11.2, D12.1
unnamed: C19.1, R48.2
unnamed: C19.2, D18.2, D19.1
unnamed: C24.1, R57.2
unnamed: C24.2, D25.2, D26.1
unnamed: C29.1, R66.2
unnamed: C29.2, D32.2, D33.1
unnamed: C34.1, R75.2
unnamed: C34.2, D39.2, D40.1
unnamed: C39.1, R84.2
unnamed: C39.2, D46.2, D47.1
unnamed: C44.1, R93.2
unnamed: C44.2, D53.2, D54.1
unnamed: C49.1, R102.2
unnamed: C49.2, D60.2, D61.1
unnamed: C54.1, R111.2
unnamed: C54.2, D67.2, D68.1
unnamed: C15.2, D10.2, D12.2, D13.1 (K), D15.1, R40.2, R42.2, R43.1, U12.6 (TS), U13.3 (Source), U14.1 (G), U15.3 (In+)
unnamed: D14.2 (A), R44.1
unnamed: D14.1 (K), U14.3 (D)
unnamed: C20.2, D17.2, D19.2, D20.1 (K), D22.1, R49.2, R51.2, R52.1, U17.6 (TS), U18.3 (Source), U19.1 (G), U20.3 (In+)
unnamed: D21.2 (A), R53.1
unnamed: D21.1 (K), U19.3 (D)
unnamed: C25.2, D24.2, D26.2, D27.1 (K), D29.1, R58.2, R60.2, R61.1, U22.6 (TS), U23.3 (Source), U24.1 (G), U25.3 (In+)
unnamed: D28.2 (A), R62.1
unnamed: D28.1 (K), U24.3 (D)
unnamed: C30.2, D31.2, D33.2, D34.1 (K), D36.1, R67.2, R69.2, R70.1, U27.6 (TS), U28.3 (Source), U29.1 (G), U30.3 (In+)
unnamed: D35.2 (A), R71.1
unnamed: D35.1 (K), U29.3 (D)
unnamed: C35.2, D38.2, D40.2, D41.1 (K), D43.1, R76.2, R78.2, R79.1, U32.6 (TS), U33.3 (Source), U34.1 (G), U35.3 (In+)
unnamed: D42.2 (A), R80.1
unnamed: D42.1 (K), U34.3 (D)
unnamed: C40.2, D45.2, D47.2, D48.1 (K), D50.1, R85.2, R87.2, R88.1, U37.6 (TS), U38.3 (Source), U39.1 (G), U40.3 (In+)
unnamed: D49.2 (A), R89.1
unnamed: D49.1 (K), U39.3 (D)
unnamed: C45.2, D52.2, D54.2, D55.1 (K), D57.1, R94.2, R96.2, R97.1, U42.6 (TS), U43.3 (Source), U44.1 (G), U45.3 (In+)
unnamed: D56.2 (A), R98.1
unnamed: D56.1 (K), U44.3 (D)
unnamed: C50.2, D59.2, D61.2, D62.1 (K), D64.1, R103.2, R105.2, R106.1, U47.6 (TS), U48.3 (Source), U49.1 (G), U50.3 (In+)
unnamed: D63.2 (A), R107.1
unnamed: D63.1 (K), U49.3 (D)
unnamed: C55.2, D66.2, D68.2, D69.1 (K), D71.1, R112.2, R114.2, R115.1, U52.6 (TS), U53.3 (Source), U54.1 (G), U55.3 (In+)
unnamed: D70.2 (A), R116.1
unnamed: D70.1 (K), U54.3 (D)
unnamed: R37.2, U11.3 (D)
unnamed: R38.1, U11.1 (G)
unnamed: C15.1, D10.1, D11.1, U12.8 (BST)
unnamed: D9.1, R38.2, R39.1, U12.5 (OL)
unnamed: C13.1, R36.2, R37.1, U12.3 (Osc)
unnamed: R41.2, R42.1, U13.1 (Gate)
unnamed: R46.2, U16.3 (D)
unnamed: R47.1, U16.1 (G)
unnamed: C20.1, D17.1, D18.1, U17.8 (BST)
unnamed: D16.1, R47.2, R48.1, U17.5 (OL)
unnamed: C18.1, R45.2, R46.1, U17.3 (Osc)
unnamed: R50.2, R51.1, U18.1 (Gate)
unnamed: R55.2, U21.3 (D)
unnamed: R56.1, U21.1 (G)
unnamed: C25.1, D24.1, D25.1, U22.8 (BST)
unnamed: D23.1, R56.2, R57.1, U22.5 (OL)
unnamed: C23.1, R54.2, R55.1, U22.3 (Osc)
unnamed: R59.2, R60.1, U23.1 (Gate)
unnamed: R64.2, U26.3 (D)
unnamed: R65.1, U26.1 (G)
unnamed: C30.1, D31.1, D32.1, U27.8 (BST)
unnamed: D30.1, R65.2, R66.1, U27.5 (OL)
unnamed: C28.1, R63.2, R64.1, U27.3 (Osc)
unnamed: R68.2, R69.1, U28.1 (Gate)
unnamed: R73.2, U31.3 (D)
unnamed: R74.1, U31.1 (G)
unnamed: C35.1, D38.1, D39.1, U32.8 (BST)
unnamed: D37.1, R74.2, R75.1, U32.5 (OL)
unnamed: C33.1, R72.2, R73.1, U32.3 (Osc)
unnamed: R77.2, R78.1, U33.1 (Gate)
unnamed: R82.2, U36.3 (D)
unnamed: R83.1, U36.1 (G)
unnamed: C40.1, D45.1, D46.1, U37.8 (BST)
unnamed: D44.1, R83.2, R84.1, U37.5 (OL)
unnamed: C38.1, R81.2, R82.1, U37.3 (Osc)
unnamed: R86.2, R87.1, U38.1 (Gate)
unnamed: R91.2, U41.3 (D)
unnamed: R92.1, U41.1 (G)
unnamed: C45.1, D52.1, D53.1, U42.8 (BST)
unnamed: D51.1, R92.2, R93.1, U42.5 (OL)
unnamed: C43.1, R90.2, R91.1, U42.3 (Osc)
unnamed: R95.2, R96.1, U43.1 (Gate)
unnamed: R100.2, U46.3 (D)
unnamed: R101.1, U46.1 (G)
unnamed: C50.1, D59.1, D60.1, U47.8 (BST)
unnamed: D58.1, R101.2, R102.1, U47.5 (OL)
unnamed: C48.1, R99.2, R100.1, U47.3 (Osc)
unnamed: R104.2, R105.1, U48.1 (Gate)
unnamed: R109.2, U51.3 (D)
unnamed: R110.1, U51.1 (G)
unnamed: C55.1, D66.1, D67.1, U52.8 (BST)
unnamed: D65.1, R110.2, R111.1, U52.5 (OL)
unnamed: C53.1, R108.2, R109.1, U52.3 (Osc)
unnamed: R113.2, R114.1, U53.1 (Gate)

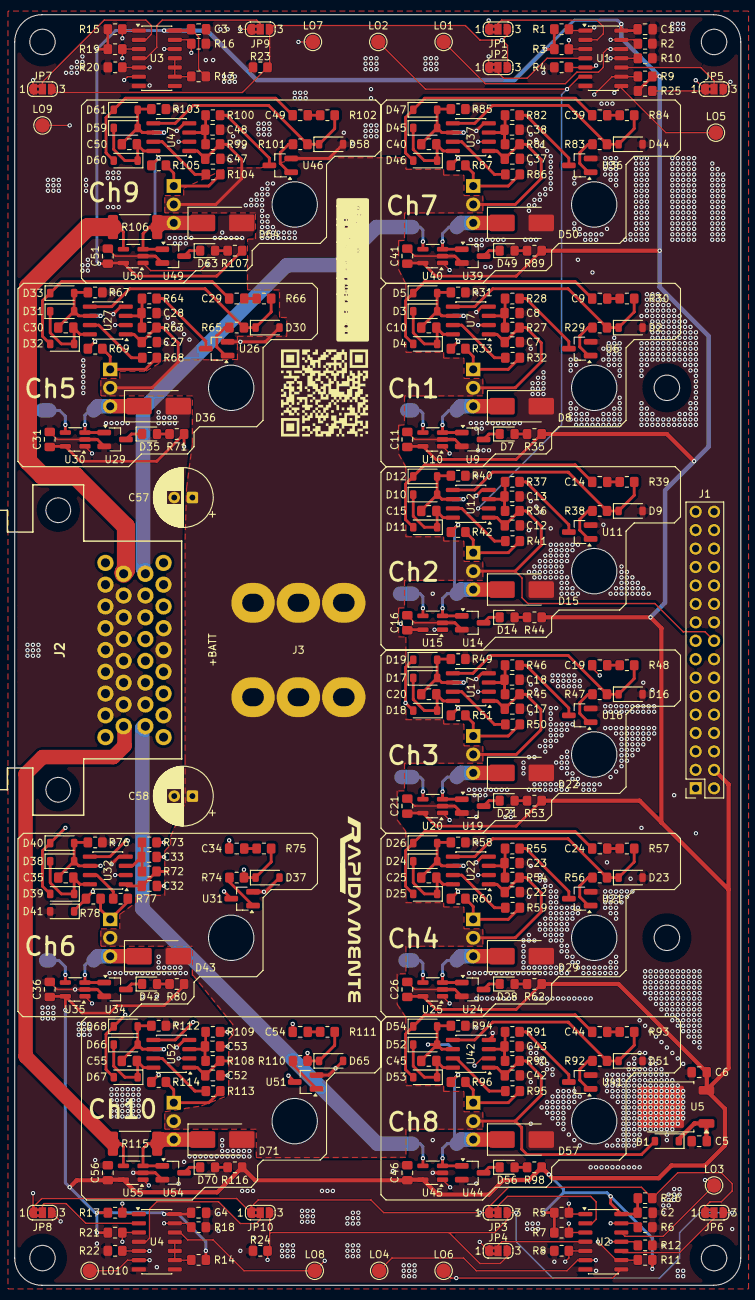
[picture p10: board KiCad_PDM.kicad_pcb from above]

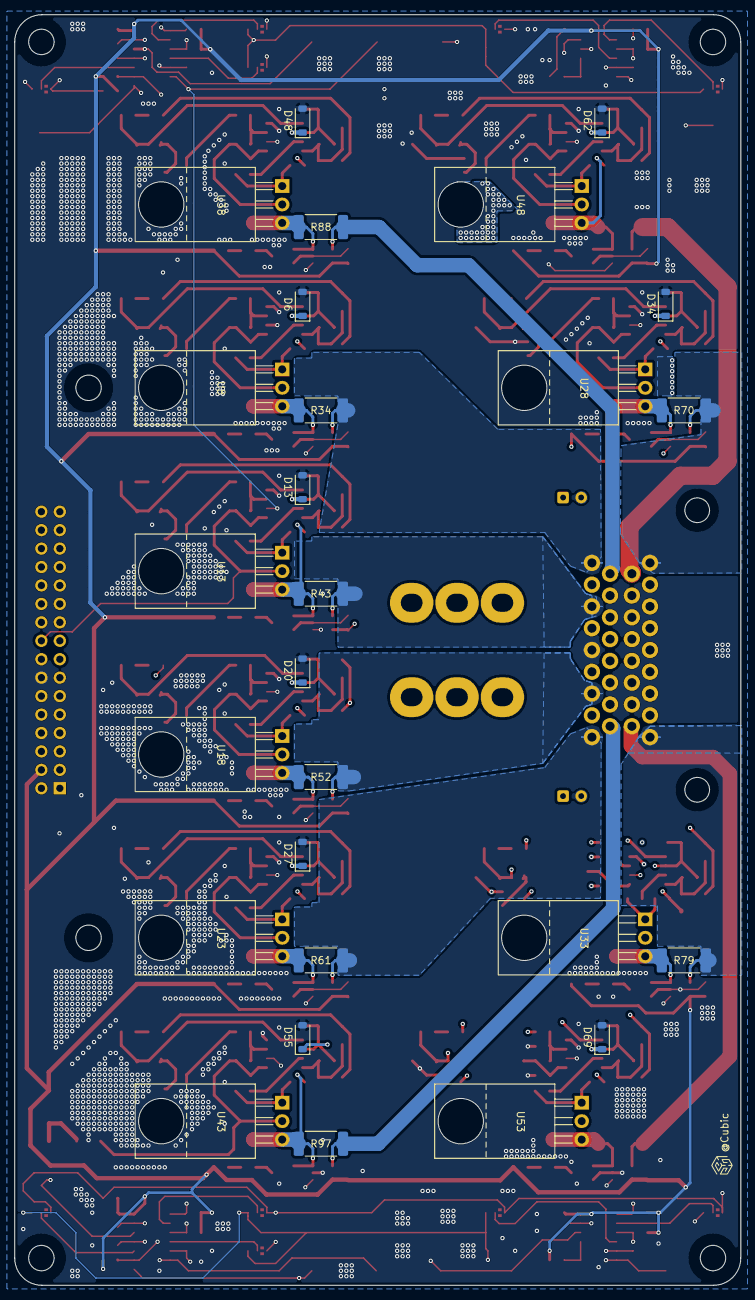
[picture p11: board KiCad_PDM.kicad_pcb from below]

Board: 4 copper layers, 100.0 x 175.0 mm, 329 parts (27 on the bottom side), 197 nets.
