NonthapatC/RapidAmentePDM/(commit log)

2026-04-13 layout and tracing
    [Gate Driver.kicad_sch, Gate_driver.kicad_sch, KiCad_PDM.kicad_pcb, KiCad_PDM.kicad_sch, XFCN T66145145-1500.step]
2026-04-13 design constraint STEP file
    [MK1_PDM_design constraint.step]
2026-04-14 silk screen changes(logos and qr codes)
    [Gate_driver.kicad_sch, KiCad_PDM.kicad_pcb, KiCad_PDM.kicad_sch]
2026-04-14 updated design and 3d models
    [Gate_driver.kicad_sch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]
2026-04-14 added bom, renamed step file
    [BOM_MK1_PDM.csv, KiCad_PDM.csv, MK1_PDM_Design_Constriant.step]
2026-04-20 updated footprint library
2026-05-05 added control board kicad files
    [STM32 V2-B_Mask.gbr, STM32 V2-B_Paste.gbr, STM32 V2-B_Silkscreen.gbr, STM32 V2-Back.gbr, STM32 V2-Edge_Cuts.gbr, STM32 V2-F_Mask.gbr, STM32 V2-F_Paste.gbr, STM32 V2-F_Silkscreen.gbr]
2026-07-26 Added TS/Souce connections, fixed flyback diode connections, fixed current sense kelvin connections
    [Gate_driver.kicad_sch, KiCad_PDM.kicad_pcb, KiCad_PDM.kicad_sch]
2026-07-29 fixed CAN trace routing (diff pair), reduced digital signal trace size to 0.2mm
    [KiCad_PDM.kicad_sch, KiCad_PDM.recovered.2026-07-28_175800.kicad_pcb]
2026-07-30 added production files (gerbers, BOM, 3D models)
    [KiCad_PDM-B_Mask.gbr, KiCad_PDM-B_Paste.gbr, KiCad_PDM-B_Silkscreen.gbr, KiCad_PDM-Back.gbr, KiCad_PDM-Edge_Cuts.gbr, KiCad_PDM-F_Mask.gbr, KiCad_PDM-F_Paste.gbr, KiCad_PDM-F_Silkscreen.gbr]
2026-08-02 fixed diff pair trace width -> 0.12mm
    [KiCad_PDM-B_Mask.gbr, KiCad_PDM-B_Paste.gbr, KiCad_PDM-B_Silkscreen.gbr, KiCad_PDM-Back.gbr, KiCad_PDM-Edge_Cuts.gbr, KiCad_PDM-F_Mask.gbr, KiCad_PDM-F_Paste.gbr, KiCad_PDM-F_Silkscreen.gbr]
2026-08-03 added new controller board (moved pinouts to match PDM, fixed CAN trace)
    [PDMController.step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]
